urish/tt05-silife-max/README.md

# Conway's Game of Life in Silicon

   

This is a hardware implementation of [Conway's Game of Life](https://en.wikipedia.org/wiki/Conway%27s_Game_of_Life) in Verilog. It is designed for [Tiny Tapeout](https://tinytapeout.com).

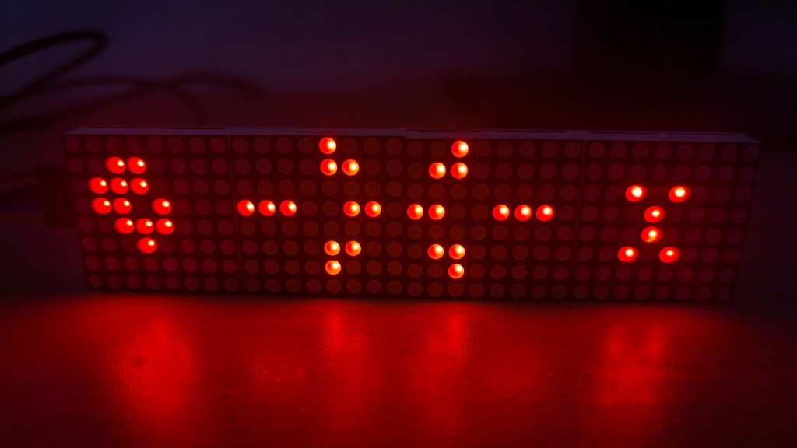
[picture p1: docs/silife-max.jpg]
SiLife on MAX7219 LED Dot Matrix
