urish/tt05-silife-max/docs/bringup.md

# Conway's Game of Life in Silicon - Bring up

Hardware required:

- MAX7219 32x8 LED Dot Matrix
- 5 jumper wires

SiLife in action

## Connections

Connect the 5 jumper wires between the side marked "IN" on the MAX7219 matrix and the "OUTPUT" port of the demo board as follows:

| OUTPUT pin | MAX7219 pin |
|---|---|
| ot0 | CS |
| ot1 | CLK |
| ot2 | DIN |
| GND | GND |
| 3v3 | VCC |

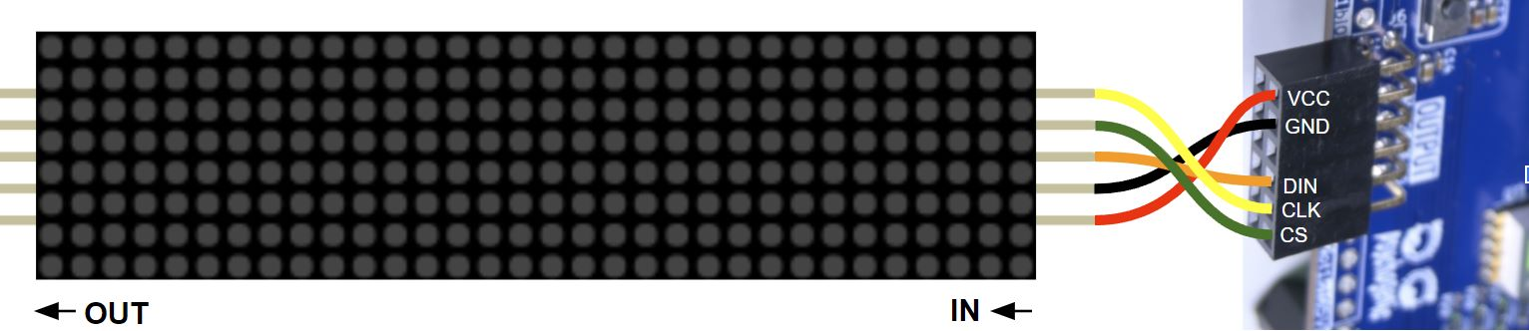
[picture p2: docs/tt-max7219-connections.jpg]
MAX7219 Matrix to Tiny Tapeout Demoboard connections


## Demo patterns

The project comes preprogrammed with two demo patterns: [demo_1](../src/demo_1.lif) and [demo_2](../src/demo_2.lif). To project in demo mode:

1. Open the [Tiny Tapeout commander app](https://commander.tinytapeout.com) and connect to your Tiny Tapeout demo board.
2. Select design number 396 "Game of Life 8x32 (siLife)", and click on the blue **SELECT** button.
3. Set the clock speed to 10 MHz, and click on the blue **SET** button.
4. Go to the INTERACT tab, check "ui_in" and click on the following buttons: **0**, **5**, **6**, **7**.
5. Click on the **RESET (R)** button.

You should see the demo pattern comes to life on the MAX7219 display. Due to a [design bug](https://github.com/urish/tt05-silife-max/issues/1), the animation may take several minutes to start for the first time. A workaround would be to speed up the project clock to 40 MHz, which will reduce the startup delay to less than 2 minutes.

You can switch to the second demo pattern by turning off button **0** and reseting the project.

Toggle button **6** to pause/reset the animation.

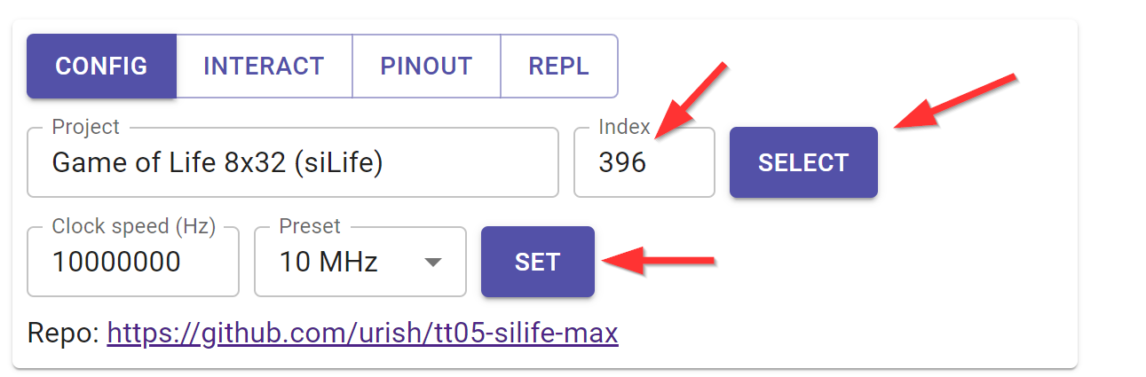
[picture p3: docs/commander-project-select.png]
Selecting the project

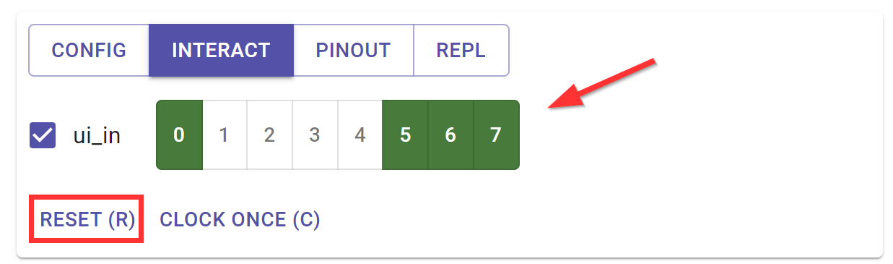
[picture p4: docs/commander-input-config.png]
Starting the demo mode


## Interactive mode

To run in interactive mode, go to the REPL tab of the commander app, press Ctrl+E, and paste the [bringup script](../bringup/silife.py). Press Ctrl+D to run the script.

You can now interact with the Game of Life by sending commands to the project. The following commands are supported:

- `R` - Generate a random pattern
- `N` - Advance to the next generation
- `D` - Dump the current grid to the console (will interfere with the MAX7219 display)
- `Q` - Quit the interactive mode and return to the REPL

Usually, you would start by generating a random pattern with `R`, and then advance to the next generation with `N`. You can repeat the `N` command to see the pattern evolve.

If you use the "D" command, you will see the current grid printed to the console. This will send some garbage to the MAX7219 display. To restore the display, you quit the interactive mode with the `Q` command and restart the project by typing `run()` in the REPL.
