urish/tt05-silife-max/test/tb.v

`default_nettype none
`timescale 1ns/1ps

/*
this testbench just instantiates the module and makes some convenient wires
that can be driven / tested by the cocotb test.py
*/

// testbench is controlled by test.py
module tb ();

    // this part dumps the trace to a vcd file that can be viewed with GTKWave
    initial begin
        $dumpfile ("tb.vcd");
        $dumpvars (0, tb);
        #1;
    end

    // wire up the inputs and outputs
    reg  clk;
    reg  rst_n;
    reg  ena;
    wire [7:0] ui_in;
    wire [7:0] uio_in;
    wire [7:0] uo_out;
    wire [7:0] uio_out;
    wire [7:0] uio_oe;

    // Silife signals
    reg en;
    reg wr_en;
    reg [4:0] row_select;
    reg [7:0] grid_in;
    wire [7:0] grid_out = uo_out;

    assign ui_in = {wr_en, en, 1'b0, row_select};
    assign uio_in = grid_in;

    tt_um_urish_silife_max silife (
    // include power ports for the Gate Level test
    `ifdef GL_TEST
        .VPWR( 1'b1),
        .VGND( 1'b0),
    `endif
        .ui_in      (ui_in),    // Dedicated inputs
        .uo_out     (uo_out),   // Dedicated outputs
        .uio_in     (uio_in),   // IOs: Input path
        .uio_out    (uio_out),  // IOs: Output path
        .uio_oe     (uio_oe),   // IOs: Enable path (active high: 0=input, 1=output)
        .ena        (ena),      // enable - goes high when design is selected
        .clk        (clk),      // clock
        .rst_n      (rst_n)     // not reset
        );

endmodule
