urish/tt05-silife-max/(commit log)

2023-10-03 fix: tie unused grid inputs to zero
    also, move en/wr_en signals to pins ui_in[7:6], to allow larger grid sizes use additional ui_in pins for row/col select.
    bump utilization to 92% to accomodate the changes.
    [silife.v]
2023-10-14 refactor: switch to openlane 1
    also fix linter (verilator) warnings
    [silife.v]
2023-10-14 test: fix wrapping for none-square grids
    [game_of_life.py]
2023-10-14 fix: support for non square grid sizes
    Add a GRID_HEIGHT macro to specify the grid height independently from the width.
    [silife.v]
2023-10-16 feat: max7219 LED matrix output
2023-10-17 refactor: rename top level module to avoid conflict with tt-silife-8x8
    [fpga_top.v, silife.v, tb.v]
2023-10-17 feat(fpga): "Z" command to reset silife
    [fpga_top.v]
2023-10-17 fix: remove `ui_in[5]` from `_unused_ok`
    it's now used
    [silife.v]
2023-10-17 feat: demo mode
    loads a preset grid if wr_en is high on reset
    [demo.v, fpga_top.v, silife.v, test.py]
2023-10-17 fix(fpga): adjust clock speed to ~10 MHz
    We plan to run the final chip at 10 MHz, so match the FPGA speed
    [fpga_top.v, rpll.v]
2023-10-17 fix(fpga): columns flipped in UART console
    [fpga_top.v]
